adamgreen/Retrochallenge-2016-January/images/20160121-03.jpg

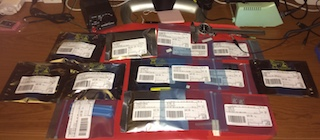
images/20160121-03.jpg
