adamgreen/Retrochallenge-2016-January/images/20160121-02.jpg

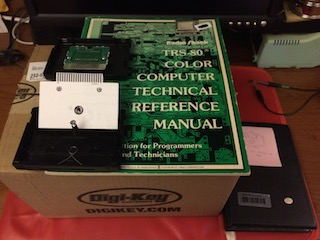
images/20160121-02.jpg
