adamgreen/Retrochallenge-2016-January/images/20160112-01.png

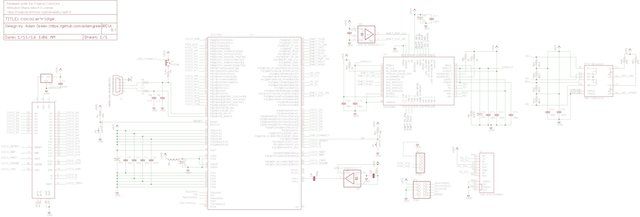
images/20160112-01.png
