adamgreen/Retrochallenge-2016-January/CoCoCartridge/Schematic.pdf

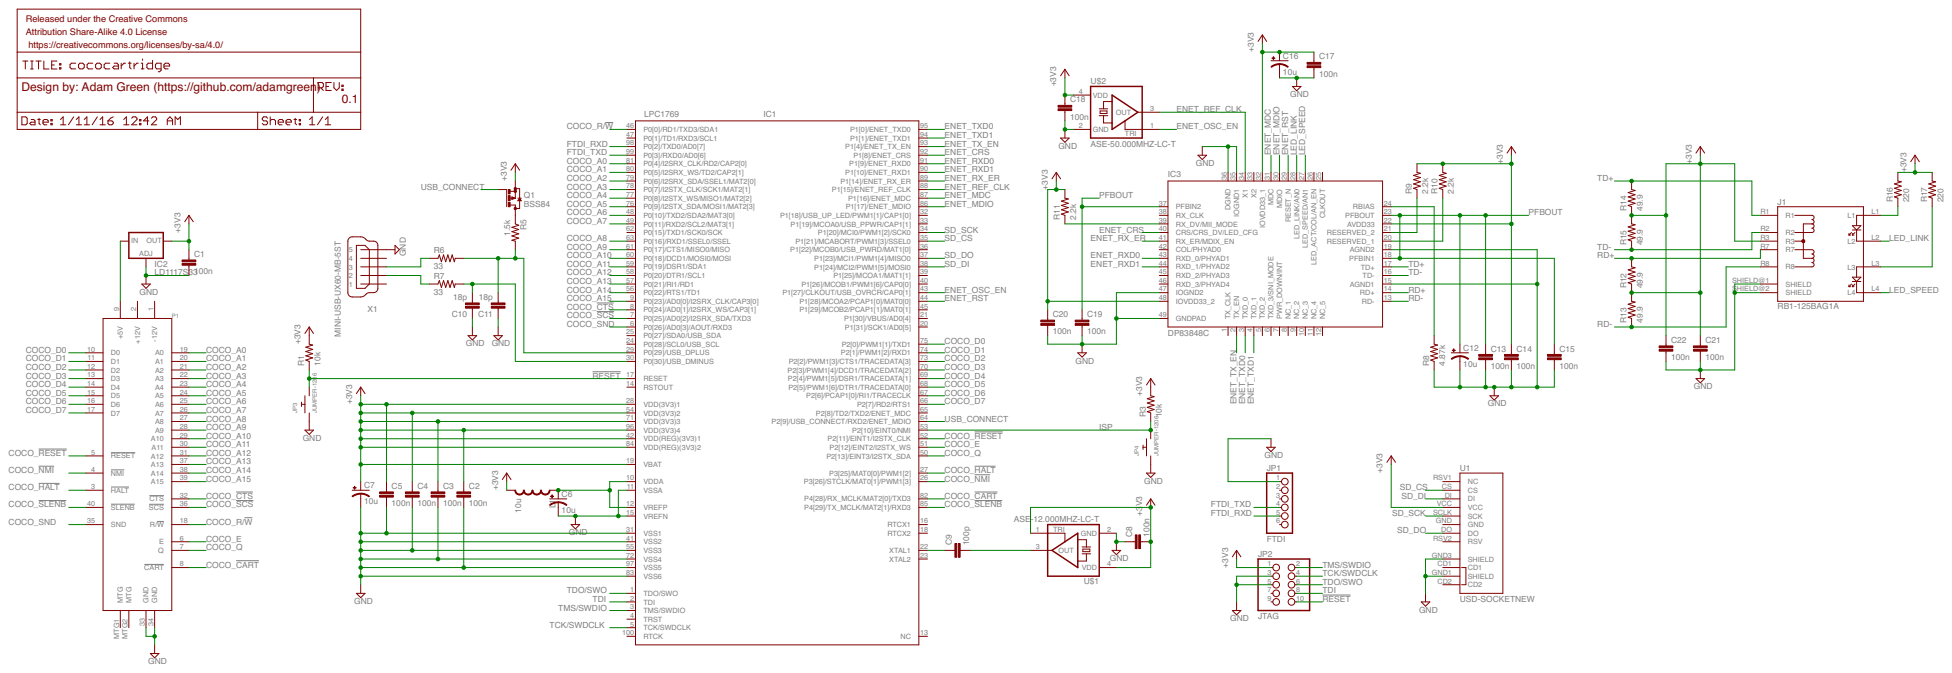
[picture p6: page 1]

Released under the Creative Commons Attribution Share-Alike 4.0 License

https://creativecommons.org/licenses/by-sa/4.0/ Design by: Adam Green (https://github.com/adamgreen)

MINI-USB-UX60-MB-5ST GND

54
71
96
42
84

55
72
