adamgreen/Retrochallenge-2016-January/CoCoCartridge/cococartridge.brd

## EAGLE design CoCoCartridge/cococartridge.brd (2016-03-25)

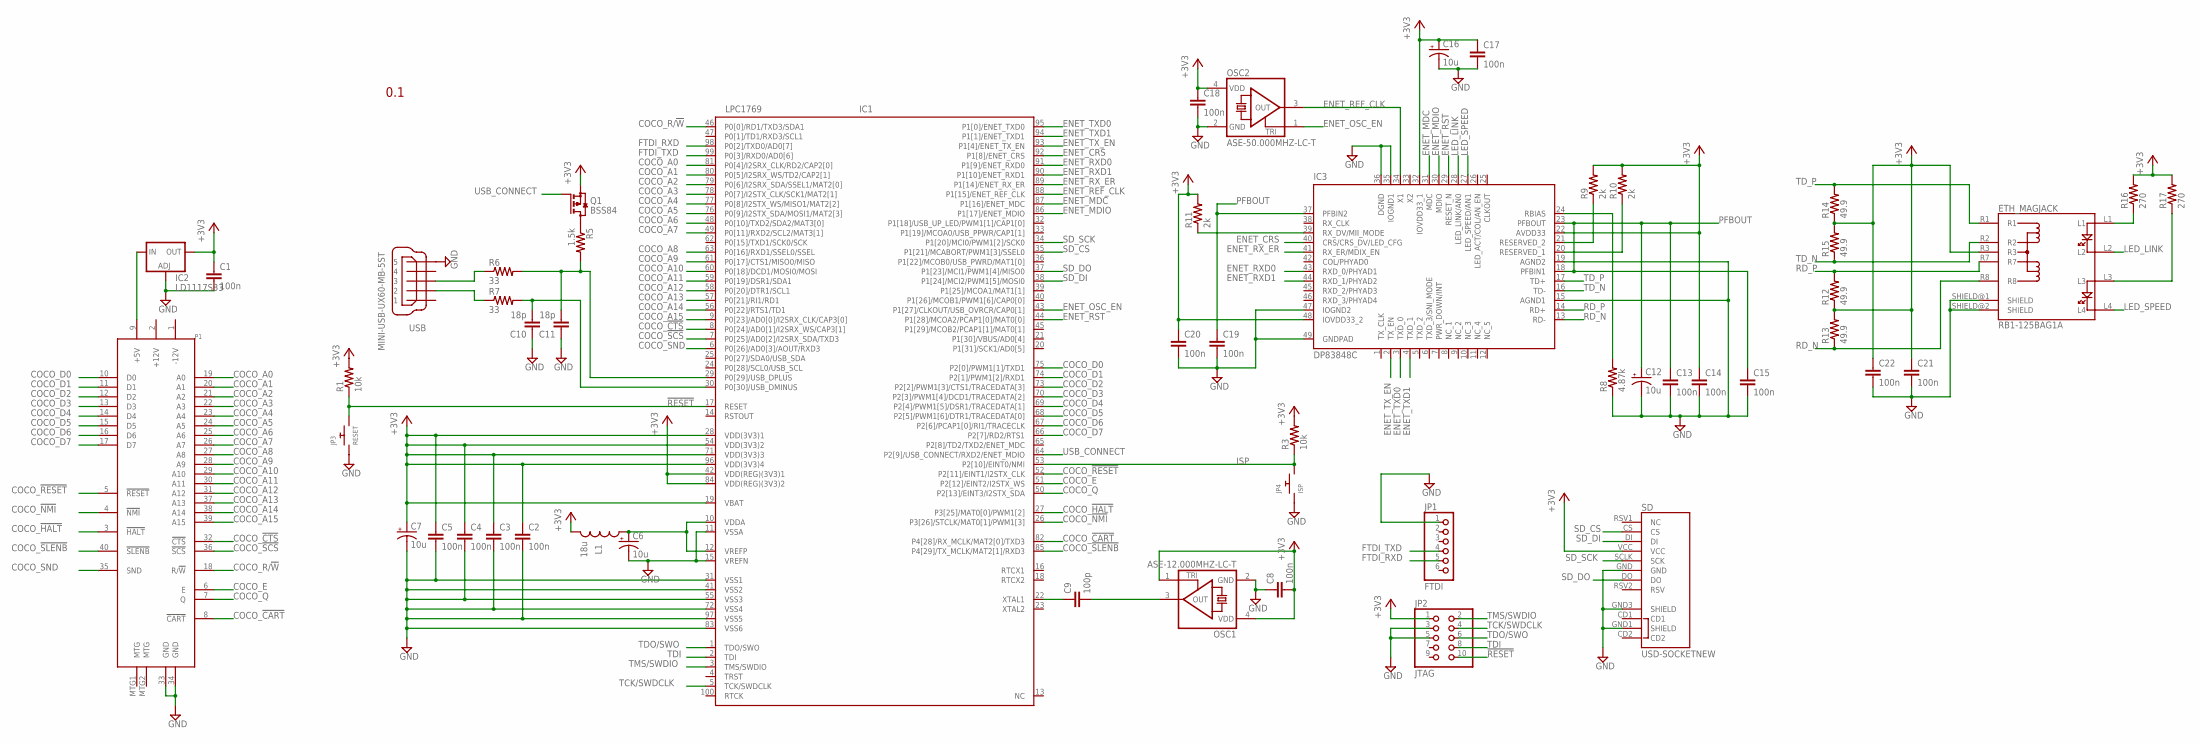
[picture p7: schematic cococartridge.sch]

Parts:
C1, C2, C3, C4, C5, C8, C13, C14, C15, C17, C18, C19, C20, C21, C22: 100n; 0805
C6, C7, C12, C16: 10u; EIA3216
C9: 100p; 0805
C10, C11: 18p; 0805
ETH_MAGJACK: RB1-125BAG1A
IC1: LPC1769; LQFP100-14X14
IC2: LD1117S33; SOT223
IC3: DP83848C; LQFP48
JP1: FTDI; 1X06
JP2: JTAG; FTSH-105
JP3: RESET; 1206
JP4: ISP; 1206
L1: 18u; 1210
OSC1: ASE-12.000MHZ-LC-T; ASE
OSC2: ASE-50.000MHZ-LC-T; ASE
P1: COCO-CART3.5X2.5; COCO-CART-3.5X2.5
Q1: BSS84; SOT23
R1, R3: 10k; 0805
R5: 1.5k; 0805
R6, R7: 33; 0805
R8: 4.87k; 0805
R9, R10, R11: 2k; 0805
R12, R13, R14, R15: 49.9; 0805
R16, R17: 270; 0805
SD: USD-SOCKETNEW; MICRO-SD-SOCKET-PP
USB: MINI-USB-UX60-MB-5ST; UX60-MB-5ST

Connections:
!RESET: IC1.17 (RESET), JP2.10, JP3.2, R1.1
+3V3: C1.1, C2.1, C3.1, C4.1, C5.1, C7.A (+), C8.2, C14.1, C16.A (+), C17.1, C18.1, C20.1, C21.1, C22.1, ETH_MAGJACK.R3, IC1.19 (VBAT), IC1.28 (VDD(3V3)1), IC1.42 (VDD(REG)(3V3)1), IC1.54 (VDD(3V3)2), IC1.71 (VDD(3V3)3), IC1.84 (VDD(REG)(3V3)2), IC1.96 (VDD(3V3)4), IC2.4 (OUT), IC3.22 (AVDD33), IC3.32 (IOVDD33_1), IC3.48 (IOVDD33_2), JP2.1, L1.2, OSC1.1 (TRI), OSC1.4 (VDD), OSC2.4 (VDD), Q1.2 (S), R1.2, R3.2, R9.2, R10.2, R11.2, R12.1, R13.2, R14.1, R15.2, R16.2, R17.2, SD.VCC
+5V: IC2.3 (IN), P1.9 (+5V)
COCO_!CART: IC1.82 (P4[28]/RX_MCLK/MAT2[0]/TXD3), P1.8 (!CART)
COCO_!CTS: IC1.8 (P0[24]/AD0[1]/I2SRX_WS/CAP3[1]), P1.32 (!CTS)
COCO_!HALT: IC1.27 (P3[25]/MAT0[0]/PWM1[2]), P1.3 (!HALT)
COCO_!NMI: IC1.26 (P3[26]/STCLK/MAT0[1]/PWM1[3]), P1.4 (!NMI)
COCO_!RESET: IC1.52 (P2[11]/EINT1/I2STX_CLK), P1.5 (!RESET)
COCO_!SCS: IC1.7 (P0[25]/AD0[2]/I2SRX_SDA/TXD3), P1.36 (!SCS)
COCO_!SLENB: IC1.85 (P4[29]/TX_MCLK/MAT2[1]/RXD3), P1.40 (!SLENB)
COCO_A0: IC1.81 (P0[4]/I2SRX_CLK/RD2/CAP2[0]), P1.19 (A0)
COCO_A1: IC1.80 (P0[5]/I2SRX_WS/TD2/CAP2[1]), P1.20 (A1)
COCO_A2: IC1.79 (P0[6]/I2SRX_SDA/SSEL1/MAT2[0]), P1.21 (A2)
COCO_A3: IC1.78 (P0[7]/I2STX_CLK/SCK1/MAT2[1]), P1.22 (A3)
COCO_A4: IC1.77 (P0[8]/I2STX_WS/MISO1/MAT2[2]), P1.23 (A4)
COCO_A5: IC1.76 (P0[9]/I2STX_SDA/MOSI1/MAT2[3]), P1.24 (A5)
COCO_A6: IC1.48 (P0[10]/TXD2/SDA2/MAT3[0]), P1.25 (A6)
COCO_A7: IC1.49 (P0[11]/RXD2/SCL2/MAT3[1]), P1.26 (A7)
COCO_A8: IC1.63 (P0[16]/RXD1/SSEL0/SSEL), P1.27 (A8)
COCO_A9: IC1.61 (P0[17]/CTS1/MISO0/MISO), P1.28 (A9)
COCO_A10: IC1.60 (P0[18]/DCD1/MOSI0/MOSI), P1.29 (A10)
COCO_A11: IC1.59 (P0[19]/DSR1/SDA1), P1.30 (A11)
COCO_A12: IC1.58 (P0[20]/DTR1/SCL1), P1.31 (A12)
COCO_A13: IC1.57 (P0[21]/RI1/RD1), P1.37 (A13)
COCO_A14: IC1.56 (P0[22]/RTS1/TD1), P1.38 (A14)
COCO_A15: IC1.9 (P0[23]/AD0[0]/I2SRX_CLK/CAP3[0]), P1.39 (A15)
COCO_D0: IC1.75 (P2[0]/PWM1[1]/TXD1), P1.10 (D0)
COCO_D1: IC1.74 (P2[1]/PWM1[2]/RXD1), P1.11 (D1)
COCO_D2: IC1.73 (P2[2]/PWM1[3]/CTS1/TRACEDATA[3]), P1.12 (D2)
COCO_D3: IC1.70 (P2[3]/PWM1[4]/DCD1/TRACEDATA[2]), P1.13 (D3)
COCO_D4: IC1.69 (P2[4]/PWM1[5]/DSR1/TRACEDATA[1]), P1.14 (D4)
COCO_D5: IC1.68 (P2[5]/PWM1[6]/DTR1/TRACEDATA[0]), P1.15 (D5)
COCO_D6: IC1.67 (P2[6]/PCAP1[0]/RI1/TRACECLK), P1.16 (D6)
COCO_D7: IC1.66 (P2[7]/RD2/RTS1), P1.17 (D7)
COCO_E: IC1.51 (P2[12]/EINT2/I2STX_WS), P1.6 (E)
COCO_Q: IC1.50 (P2[13]/EINT3/I2STX_SDA), P1.7 (Q)
COCO_R/!W: IC1.46 (P0[0]/RD1/TXD3/SDA1), P1.18 (R/!W)
COCO_SND: IC1.6 (P0[26]/AD0[3]/AOUT/RXD3), P1.35 (SND)
ENET_CRS: IC1.92 (P1[8]/ENET_CRS), IC3.40 (CRS/CRS_DV/LED_CFG)
ENET_MDC: IC1.87 (P1[16]/ENET_MDC), IC3.31 (MDC)
ENET_MDIO: IC1.86 (P1[17]/ENET_MDIO), IC3.30 (MDIO)
ENET_OSC_EN: IC1.43 (P1[27]/CLKOUT/USB_OVRCR/CAP0[1]), OSC2.1 (TRI)
ENET_REF_CLK: IC1.88 (P1[15]/ENET_REF_CLK), IC3.34 (X1), OSC2.3 (OUT)
ENET_RST: IC1.44 (P1[28]/MCOA2/PCAP1[0]/MAT0[0]), IC3.29 (RESET_N)
ENET_RXD0: IC1.91 (P1[9]/ENET_RXD0), IC3.43 (RXD_0/PHYAD1)
ENET_RXD1: IC1.90 (P1[10]/ENET_RXD1), IC3.44 (RXD_1/PHYAD2)
ENET_RX_ER: IC1.89 (P1[14]/ENET_RX_ER), IC3.41 (RX_ER/MDIX_EN)
ENET_TXD0: IC1.95 (P1[0]/ENET_TXD0), IC3.3 (TXD_0)
ENET_TXD1: IC1.94 (P1[1]/ENET_TXD1), IC3.4 (TXD_1)
ENET_TX_EN: IC1.93 (P1[4]/ENET_TX_EN), IC3.2 (TX_EN)
FTDI_RXD: IC1.98 (P0[2]/TXD0/AD0[7]), JP1.5
FTDI_TXD: IC1.99 (P0[3]/RXD0/AD0[6]), JP1.4
GND: C1.2, C2.2, C3.2, C4.2, C5.2, C6.C (-), C7.C (-), C8.1, C10.1, C11.1, C12.C (-), C13.2, C14.2, C15.2, C16.C (-), C17.2, C18.2, C19.2, C20.2, C21.2, C22.2, ETH_MAGJACK.SHIELD@1 (SHIELD), ETH_MAGJACK.SHIELD@2 (SHIELD), IC1.11 (VSSA), IC1.15 (VREFN), IC1.31 (VSS1), IC1.41 (VSS2), IC1.55 (VSS3), IC1.72 (VSS4), IC1.83 (VSS6), IC1.97 (VSS5), IC2.1 (ADJ), IC3.15 (AGND1), IC3.19 (AGND2), IC3.35 (IOGND1), IC3.36 (DGND), IC3.47 (IOGND2), IC3.49 (GNDPAD), JP1.1, JP2.3, JP2.5, JP3.1, JP4.1, OSC1.2 (GND), OSC2.2 (GND), P1.33 (GND), P1.34 (GND), R8.1, SD.GND, SD.GND1 (SHIELD), SD.GND3 (SHIELD), USB.5
ISP: IC1.53 (P2[10]/EINT0/NMI), JP4.2, R3.1
LED_LINK: ETH_MAGJACK.L2, IC3.28 (LED_LINK/AN0)
LED_SPEED: ETH_MAGJACK.L4, IC3.27 (LED_SPEED/AN1)
unnamed: C6.A (+), IC1.10 (VDDA), IC1.12 (VREFP), L1.1
unnamed: C9.1, IC1.22 (XTAL1)
unnamed: C9.2, OSC1.3 (OUT)
unnamed: IC3.24 (RBIAS), R8.2
unnamed: Q1.3 (D), R5.1
unnamed: IC3.39 (RX_DV/MII_MODE), R11.1
unnamed: IC3.21 (RESERVED_2), R9.1
unnamed: IC3.20 (RESERVED_1), R10.1
unnamed: ETH_MAGJACK.L1, R16.1
unnamed: ETH_MAGJACK.L3, R17.1
PFBOUT: C12.A (+), C13.1, C15.1, C19.1, IC3.18 (PFBIN1), IC3.23 (PFBOUT), IC3.37 (PFBIN2)
RD_N: ETH_MAGJACK.R8, IC3.13 (RD-), R13.1
RD_P: ETH_MAGJACK.R7, IC3.14 (RD+), R12.2
SD_CS: IC1.35 (P1[21]/MCABORT/PWM1[3]/SSEL0), SD.CS
SD_DI: IC1.38 (P1[24]/MCI2/PWM1[5]/MOSI0), SD.DI
SD_DO: IC1.37 (P1[23]/MCI1/PWM1[4]/MISO0), SD.DO
SD_SCK: IC1.34 (P1[20]/MCI0/PWM1[2]/SCK0), SD.SCLK (SCK)
TCK/SWDCLK: IC1.5 (TCK/SWDCLK), JP2.4
TDI: IC1.2 (TDI), JP2.8
TDO/SWO: IC1.1 (TDO/SWO), JP2.6
TD_N: ETH_MAGJACK.R2, IC3.16 (TD-), R15.1
TD_P: ETH_MAGJACK.R1, IC3.17 (TD+), R14.2
TMS/SWDIO: IC1.3 (TMS/SWDIO), JP2.2
USB2_N: R7.1, USB.2
USB2_P: R6.1, USB.3
USB_CONNECT: IC1.64 (P2[9]/USB_CONNECT/RXD2/ENET_MDIO), Q1.1 (G)
USB_N: C10.2, IC1.30 (P0[30]/USB_DMINUS), R7.2
USB_P: C11.2, IC1.29 (P0[29]/USB_DPLUS), R5.2, R6.2

Notes on the sheet:
0.1

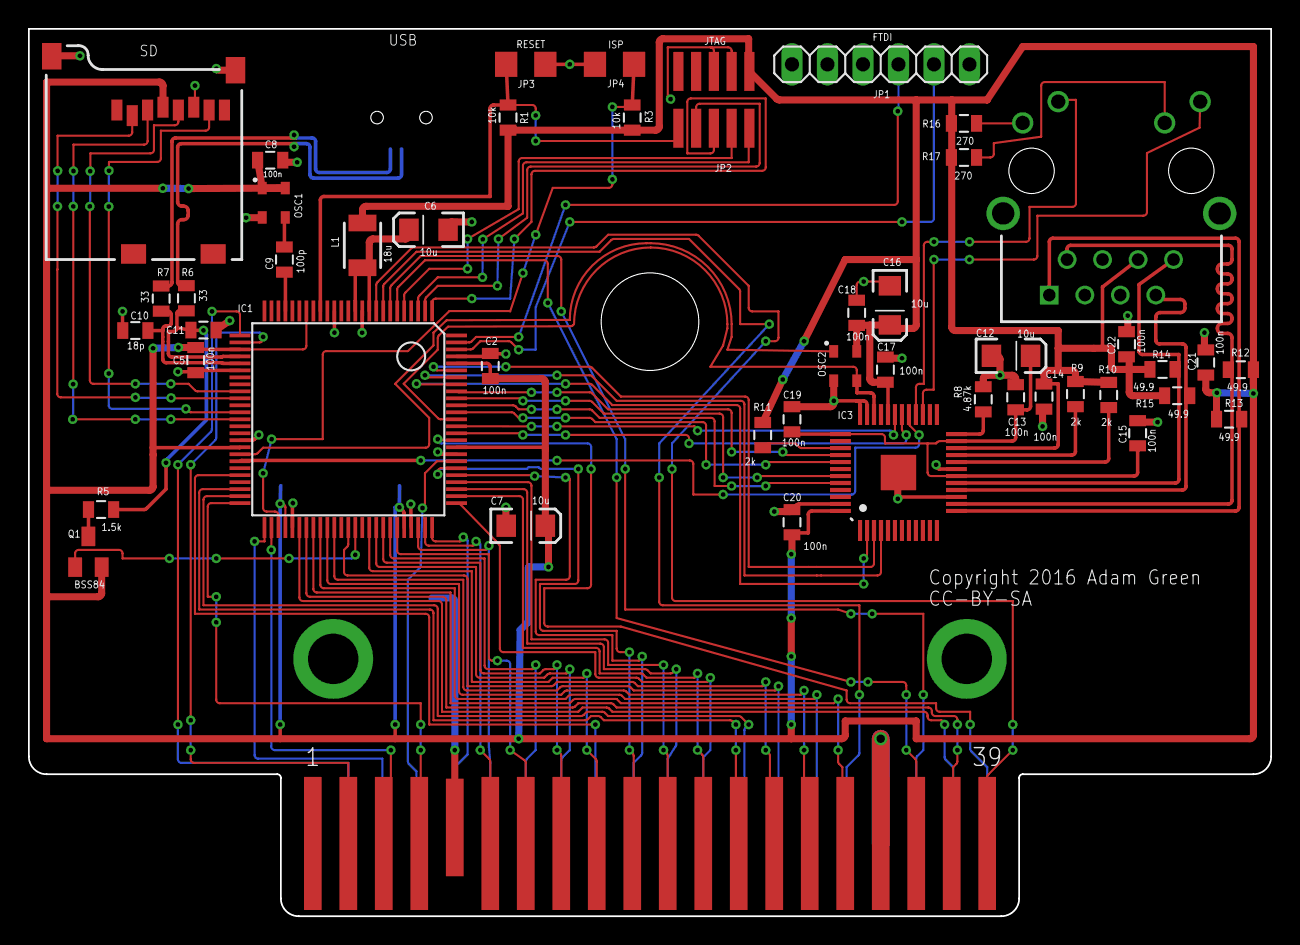
[picture p8: board cococartridge.brd from above]

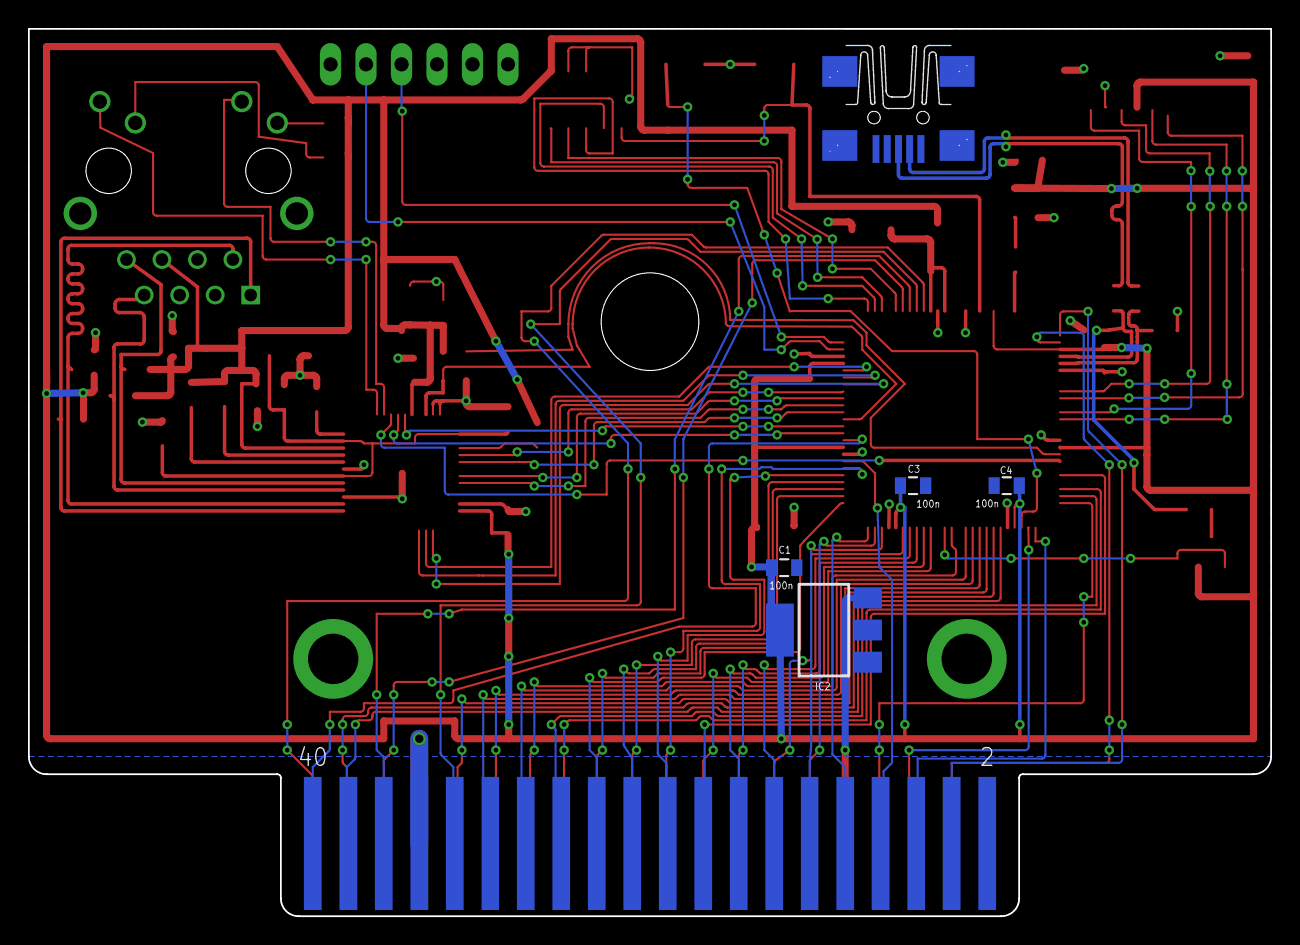
[picture p9: board cococartridge.brd from below]

Board: 2 copper layers, 88.9 x 63.5 mm, 52 parts (5 on the bottom side), 84 nets.
