adamgreen/Retrochallenge-2016-January/(commit log)

2016-01-12 Initial commit of CoCoCartridge Eagle project
    The Eagle project only contains my first attempt at the schematic so
    far. It interfaces a NXP LPC1769 Cortex-M3 microcontroller to the
    CoCo cartridge port. The LPC1768 takes advantage of its USB and
    Ethernet peripheral blocks to communicate with modern hardware and
    uses SPI to provide access to uSD cards.
    Uses the following license:
    Creative Commons Attribution-ShareAlike 4.0
    International Public License
    See CoCoCartridge/LICENSE for more information.
    I archived the datasheets for several of the parts that I am currently
    planning to use with this project.
    [cococartridge.sch]
2016-01-13 Add scaled down image of schematic
    This is just a thumbnail of the actual schematic PDF.
2016-01-30 First attempt at manual routing
    Yet to be done:
    * Get it reviewed by an actual EE.
    * Clean up the component labels, etc.
    * Verify component footprints.
    [cococartridge.brd, cococartridge.sch]
2016-01-31 Add photo of board
    This is a screen capture of the board after I first got all of the
    traces placed.
2016-02-01 Add copyright text to board silkscreen
    CC-BY-SA
    [cococartridge.brd]
2016-02-09 Revision 1.0 sent to OSHPark
    This is the first version that I sent off to OSHPark for manufacturing
    tonight.
    [cococartridge.brd, cococartridge.sch]
2016-03-25 Fix missing Gnd connection on SD socket
    I connected the shield pins labelled ground to the actual ground but
    forgot to connect the actual ground pin of the SD card to my ground
    plane.
    [cococartridge.brd, cococartridge.sch]
