adamgreen/Retrochallenge-2016-January/(notices)

Notices in the files:
CoCoCartridge/cococartridge.brd:
Copyright 2016 Adam Green
CC-BY-SA
parts and their libraries:
adam_custom: Creative Commons Attribution-Share Alike 4.0 License Document Field
SparkFun-Resistors: Licensing: Creative Commons ShareAlike 4.0 International - https://creativecommons.org/licenses/by-sa/4.0
